Bhavya-Chawat/Smart-Rain-Shed-Controller/README.md

# Smart-Rain-Shed-Controller
An IoT-based automatic rain shed controller using ESP32, Blynk, sensors, and cloud integration.
