Bhavya-Chawat/Smart-Rain-Shed-Controller/Poster.pdf

RV College of Engineering, Bengaluru – 560059.

## Smart Rain Shed Controller

Aaradhya Saxena | Aniketa Subudhi | Bhavya Chawat | Chetan Anand N
1RV24IS003 | 1RV24IS014 | 1RV24IS025| 1RV24IS028 | Keshava Murthy Y C

### Empirical, Calculations, Tools & Techniques

Introduction | Results & Discussions

### Testing/Validation & Feedback

References

## Go, change the world

### Methodology

### Objectives

Branch:ISE
Section:A
Batch:1

### Measurable Outcomes

QR codes

IDEA LAB SEE Project - II SEM

2024-2025

Rao, N., & Naik, A. (2020). Automated window blind system using IoT. International Journal of Scientific Research in Engineering and Management, 4(12), 1–5.

Shinde, S., & Kadam, V. (2020). IoT based smart home automation using Blynk. International Journal of Creative Research Thoughts, 8(6), 3467–3471.

Jayakrista, S., & Wowiling, R. G. (2024). Prototype of IoT-based clothes drying control system using infrared thermometer MLX90614. Journal of Computer Engineering, Electronics and Information Technology (COELITE), 3(1), 27–34.

In urban households, terraces are often used for drying clothes but remain exposed to sudden rain or low sunlight. This project introduces a smart, IoT-based shed system that automatically responds to rainfall, ambient light, and real-time weather data. Built using an ESP32, rain and LDR sensors, and Tomorrow.io API, it supports manual override, remote control via the Blynk app, and time-based automation. Powered by solar energy, the system is cost-effective, efficient, and ideal for residential use.

- Automate shed movement based on rain and light detection
- Use real-time weather data via Tomorrow.io API
- Provide manual override through switch and Blynk app
- Log events and data to Google Sheets in real-time
- Ensure solar-powered, energy-efficient operation
- Implement time-based automation to limit operation to specific hour

Rain Intensity Mapping
Analog rain sensor values (0–4095) mapped to 0–100% scale for precise detection
Rain % = map(analogValue, 4095, 250, 0, 100)

Tools Used

Hardware: ESP32, L298N, Rain Sensor, LDR, LCD, DC Motor Software: Arduino IDE, Blynk IoT App, Google Sheets, Tomorrow.io API

False Trigger Prevention: 5-second debounce + API cross-check

Real-time Data Logging: Auto-send to Google Sheets every 30 seconds

Fail-Safe Mode: Shed operable via button during Wi-Fi/app failure

- The system accurately detected rain and light conditions, responding

in real time

- Weather API integration improved reliability of shed control

decisions

- Manual override via switch and Blynk app worked seamlessly
- Data logging to Google Sheets and live LCD updates were consistent
- The solar-powered setup ensured stable and energy-efficient

operation.

- System was tested under real rain and simulated weather conditions
- Sensor readings matched expected environmental changes accurately
- False trigger prevention logic (5s debounce + API check) worked effectively
- Manual and auto modes were validated by repeated open/close cycles
- Time-based automation validated using user-set hours in Blynk app
- Data logging to Google Sheets confirmed every 30 seconds with accurate records
